nicolavianello95/RISC-V/schematics/schematic_comparator.png

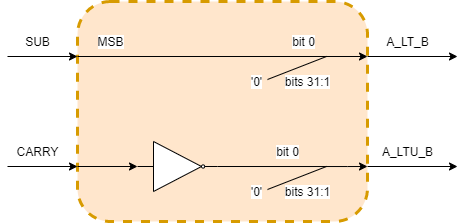
schematics/schematic_comparator.png
