nicolavianello95/RISC-V/schematics/schematic_datapath.png

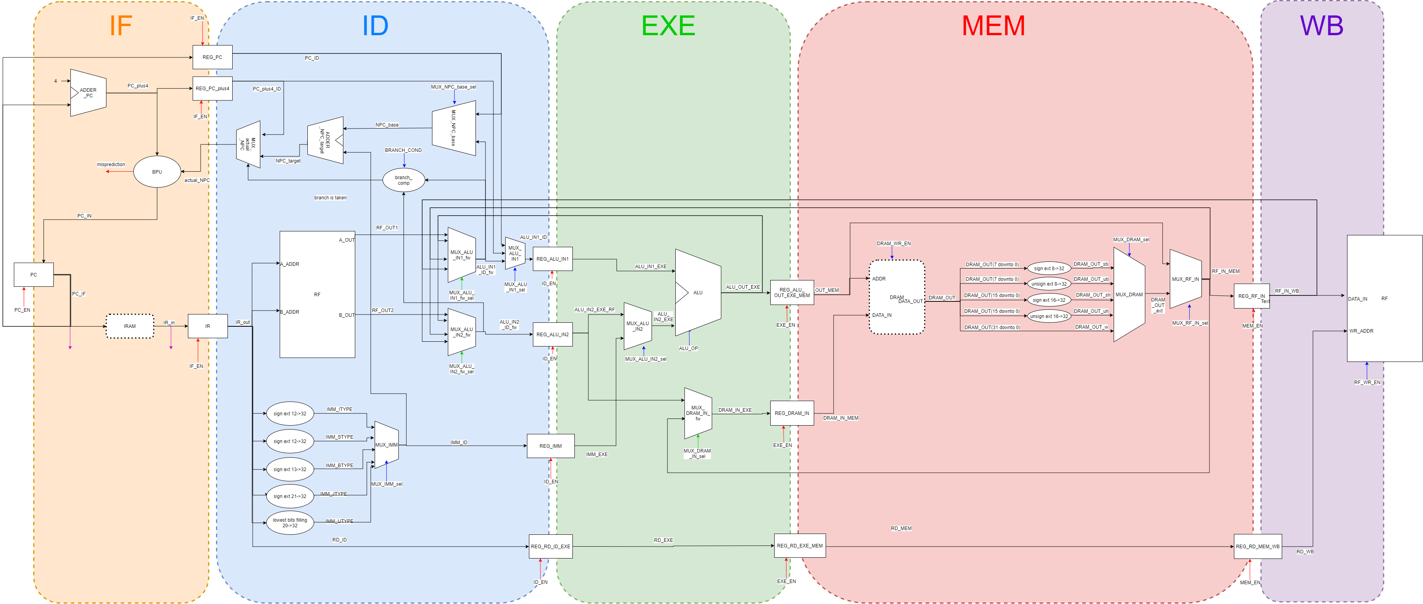
schematics/schematic_datapath.png
